smit2400/Trap_PCB/hardware/main-board/bom/TRAP_main_BOM.csv

Id | Designator | Package | Quantity | Designation | Supplier and ref
1 | R16,R23,R28 | 1206 | 3 | 100K
2 | C12,C1 | CPOL-RADIAL-2.5MM-6.5MM | 2 | 100UF 25V
3 | C2,C8,C4,C7,C11,C3,C5,C6 | 1206 | 8 | smd
4 | C10 | 1206 | 1 | NC
5 | J4,J6,J5 | JST_EH_B2B-EH-A_1x02_P2.50mm_Vertical | 3 | 01x02
6 | J1,J8,J3,J7,J10,J11,J2,J9 | 1X02 | 8 | 01x02
7 | R27 | 1206 | 1 | 11K
8 | D1,D2 | 1210 | 2 | D_Schottky
9 | Q1 | SOT23-3 | 1 | 2A PNP tran
10 | R29,R10,R5,R30,R6,R24,R11 | 1206 | 7 | 10K
11 | R4,R25,R33,R22,R26,R32,R15,R12,R2,R1,R13,R34 | 1206 | 12 | 1K
12 | D3,D4 | 1210 | 2 | D_Zener
13 | IC1 | SOP65P810X140-30N | 1 | R5F100ACASP#V0-R5F100ACASP#V0
14 | R31,R9,R39,R41 | 1206 | 4 | 0
15 | R37,R38,R20,R35,R40,R36 | 1206 | 6 | JMP
16 | R14 | 1206 | 1 | 51K
17 | Q5 | SOT23-3 | 1 | 5C2
18 | R17 | 1206 | 1 | 2E
19 | Q7 | SOT23-3 | 1 | A49T
20 | R19,R8,R3 | 1206 | 3 | 100
21 | D8,D7 | LED-1206 | 2 | LED
22 | J12 | 1X04 | 1 | 01x04
23 | C9 | CAPPRD500W60D1000H1250 | 1 | 100uF 35V
24 | Q2 | SOT23-3 | 1 | W1p
25 | Q4 | SOT23-3 | 1 | W1P
26 | U1 | SOT89R | 1 | MC78L05_TO92
27 | Q6 | SOT23-3 | 1 | W1P
28 | R18 | 1206 | 1 | 4.7K
29 | R21 | 1206 | 1 | 5.1
30 | D5 | 1210 | 1 | 1N4007
31 | R7 | 1206 | 1 | 22K
32 | D6 | 1210 | 1 | NC
33 | Q3 | SOT23-3 | 1 | A19T
34 | J13 | 1X02_BIG | 1 | 01x02
