smit2400/Trap_PCB/hardware/main-board/Trap_smit.kicad_pcb

## KiCad design hardware/main-board/Trap_smit.kicad_pcb (2026-11-07)

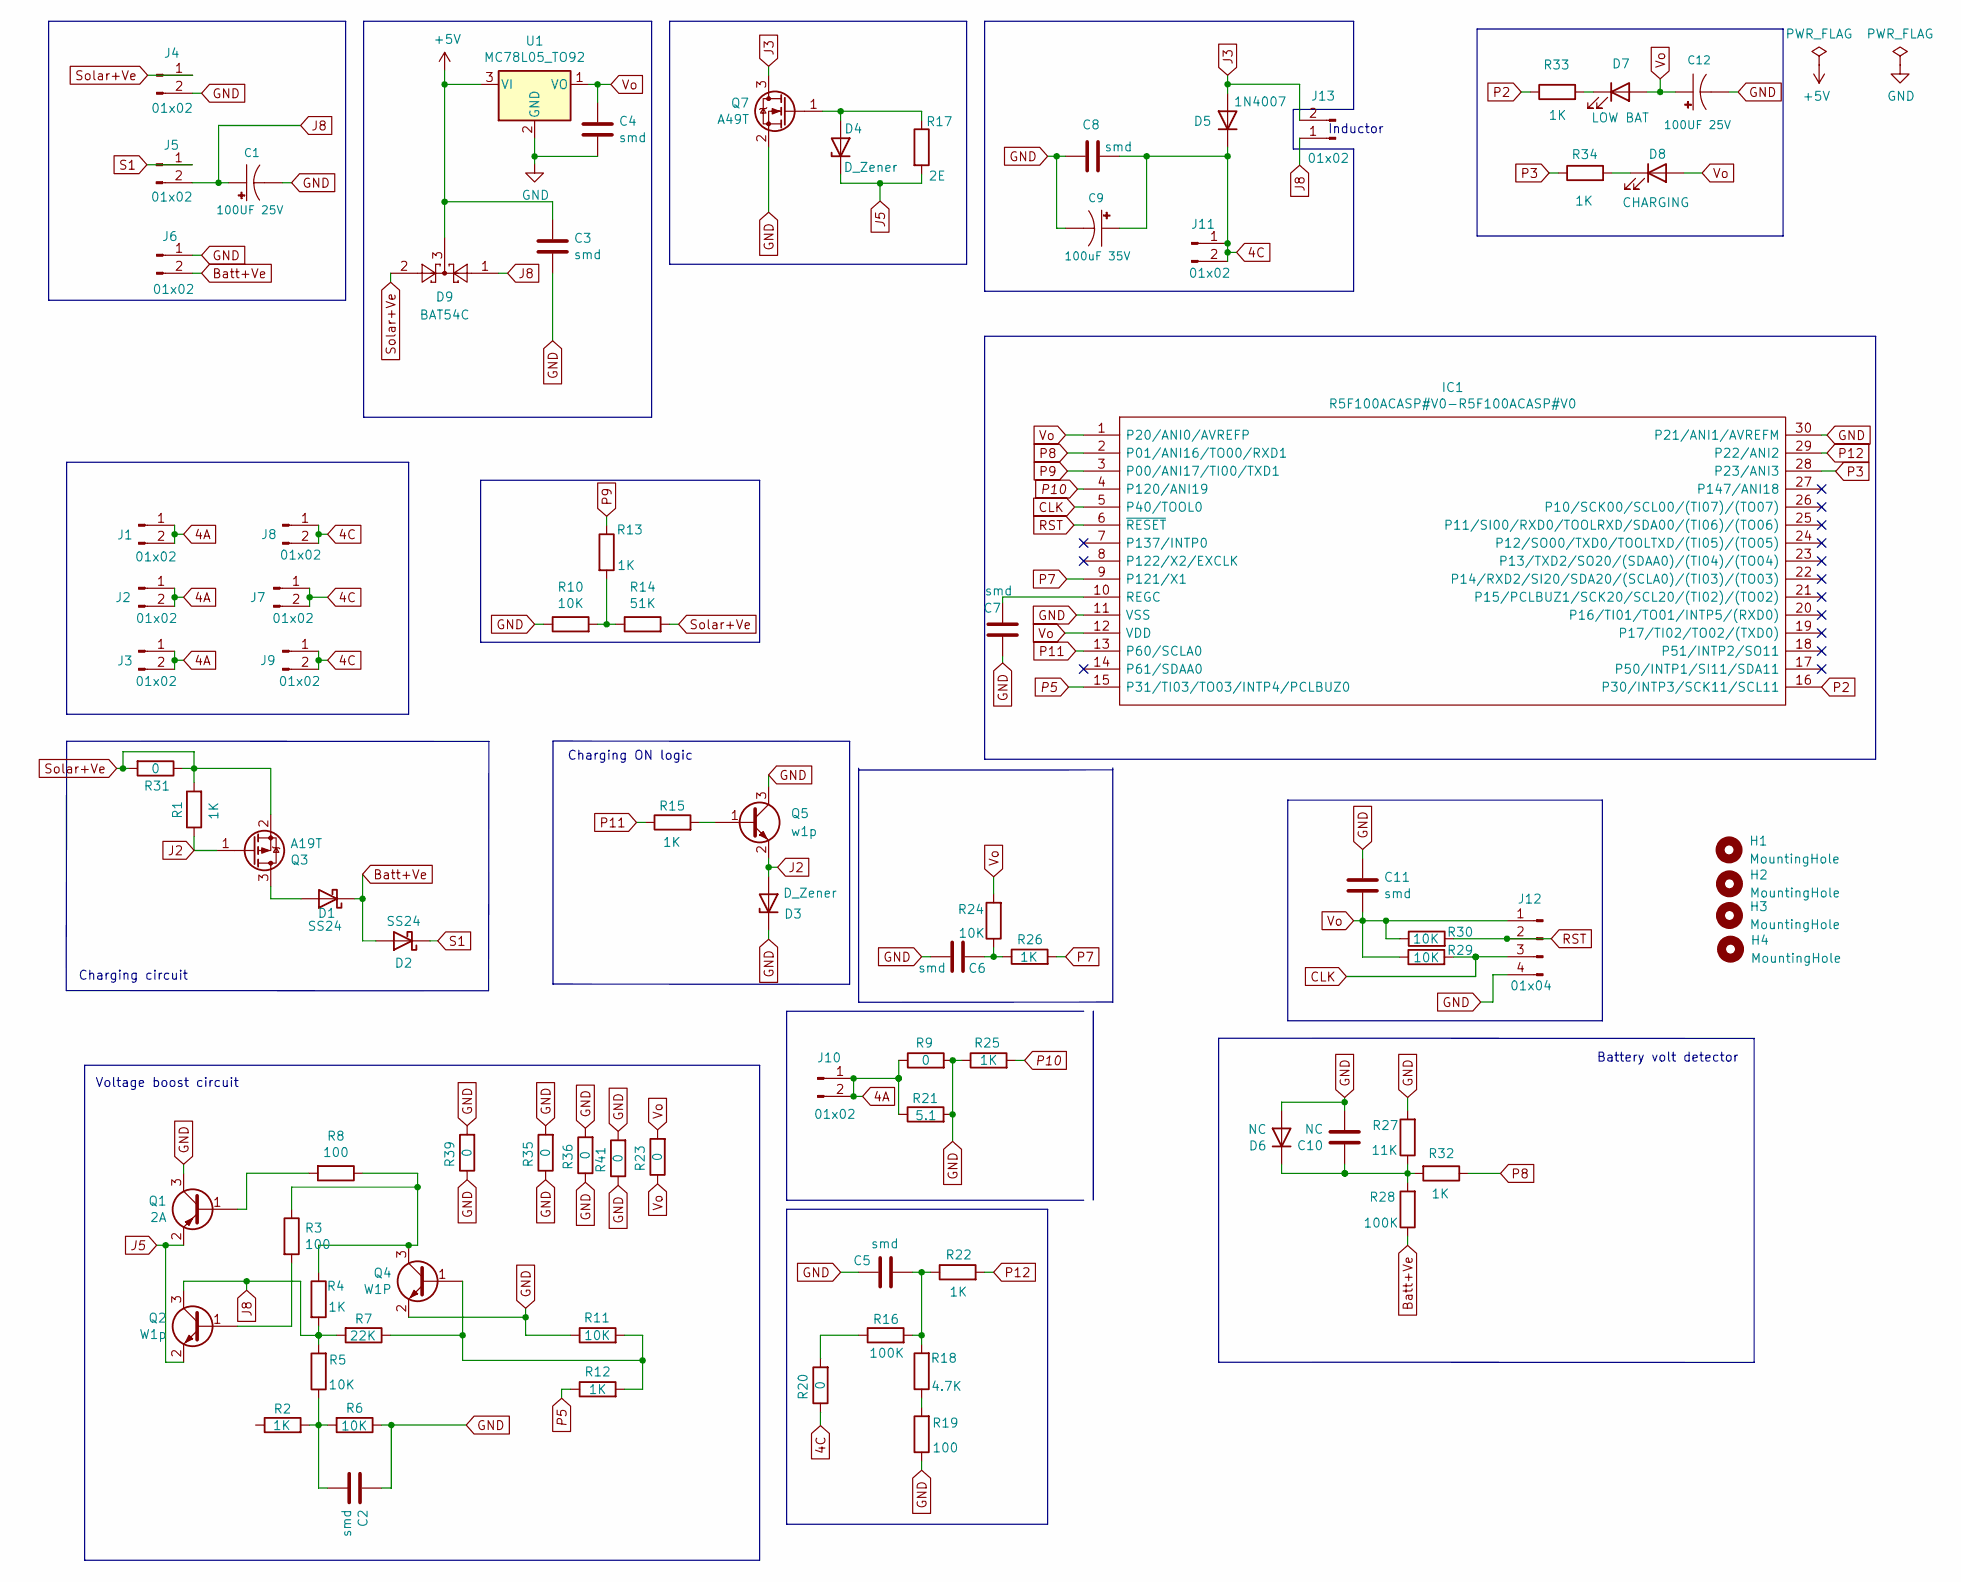
[picture p2: schematic Trap_smit.kicad_sch]

Parts:
C1, C12: 100UF 25V; CPOL-RADIAL-2.5MM-6.5MM
C2, C3, C4, C5, C6, C7, C8, C11: smd; 1206
C9: 100uF 35V; CAPPRD500W60D1000H1250
C10: NC; 1206
D1, D2: SS24; 1210
D3, D4: D_Zener; 1210
D5: 1N4007; 1210
D6: NC; 1210
D7: LOW BAT; LED-1206
D8: CHARGING; LED-1206
D9: BAT54C; SOT23-3
H1, H2, H3, H4: MountingHole; MountingHole_3.2mm_M3
IC1: R5F100ACASP#V0-R5F100ACASP#V0; SOP65P810X140-30N; Manufacturer_Part_Number R5F100ACASP#V0; Mouser Part Number 968-R5F100ACASP#V0
J1, J2, J3, J7, J8, J9, J10, J11: 01x02; 1X02
J4, J5, J6: 01x02; JST_EH_B2B-EH-A_1x02_P2.50mm_Vertical
J12: 01x04; 1X04
J13: 01x02; 1X02_BIG
Q1: 2A; SOT23-3
Q2: W1p; SOT23-3
Q3: A19T; SOT23-3
Q4: W1P; SOT23-3
Q5: w1p; SOT23-3
Q7: A49T; SOT23-3
R1, R2, R4, R12, R13, R15, R22, R25, R26, R32, R33, R34: 1K; 1206
R3, R8, R19: 100; 1206
R5, R6, R10, R11, R24, R29, R30: 10K; 1206
R7: 22K; 1206
R9, R20, R23, R31, R35, R36, R39, R41: 0; 1206
R14: 51K; 1206
R16, R28: 100K; 1206
R17: 2E; 1206
R18: 4.7K; 1206
R21: 5.1; 1206
R27: 11K; 1206
U1: MC78L05_TO92; SOT89R

Connections:
4A: J1.1, J1.2, J2.1, J2.2, J3.1, J3.2, J10.1, J10.2, R9.1, R21.1
4C: C8.2, C9.+, D5.1 (K), J7.1, J7.2, J8.1, J8.2, J9.1, J9.2, J11.1, J11.2, R20.1
+5V: C3.1, D9.3, U1.3 (VI)
Batt+Ve: D1.1 (K), D2.2 (A), J6.2, R28.1
CLK: IC1.5 (P40/TOOL0), J12.3, R29.2
GND: C1.2 (-), C2.1, C3.2, C4.2, C5.1, C6.2, C7.2, C8.1, C9.-, C10.2, C11.1, C12.2 (-), D3.1 (K), D6.2 (A), IC1.11 (VSS), IC1.30 (P21/ANI1/AVREFM), J4.2, J6.1, J12.4, Q1.3 (C), Q4.2 (E), Q5.3 (C), Q7.2 (S), R6.1, R9.2, R10.1, R11.1, R19.1, R21.2, R25.1, R27.2, R35.1, R35.2, R36.1, R36.2, R39.1, R39.2, R41.1, R41.2, U1.2 (GND)
J2: D3.2 (A), Q3.1 (G), Q5.2 (E), R1.1
J3: D5.2 (A), J13.2, Q7.3 (D)
J5: D4.1 (K), Q1.2 (E), Q2.2 (E), R17.2
J8: C1.1 (+), D9.1, J5.2, J13.1, Q2.3 (C), R4.2, R5.2, R7.2
unnamed: C2.2, R2.2, R5.1, R6.2
unnamed: C5.2, R16.2, R18.2, R22.1
unnamed: C6.1, R24.1, R26.1
unnamed: C7.1, IC1.10 (REGC)
unnamed: C10.1, D6.1 (K)
unnamed: D1.2 (A), Q3.3 (D)
unnamed: D4.2 (A), Q7.1 (G), R17.1
unnamed: D7.1 (K), R33.2
unnamed: D8.1 (K), R34.2
unnamed: Q1.1 (B), R8.2
unnamed: Q2.1 (B), R3.2
unnamed: Q4.1 (B), R7.1, R11.2, R12.2
unnamed: Q4.3 (C), R3.1, R4.1, R8.1
unnamed: R10.2, R13.2, R14.1
unnamed: Q5.1 (B), R15.2
unnamed: R16.1, R20.2
unnamed: R18.1, R19.2
unnamed: R27.1, R28.2, R32.2
P2: IC1.16 (P30/INTP3/SCK11/SCL11), R33.1
P3: IC1.28 (P23/ANI3), R34.1
P5: IC1.15 (P31/TI03/TO03/INTP4/PCLBUZ0), R12.1
P7: IC1.9 (P121/X1), R26.2
P8: IC1.2 (P01/ANI16/TO00/RXD1), R32.1
P9: IC1.3 (P00/ANI17/TI00/TXD1), R13.1
P10: IC1.4 (P120/ANI19), R25.2
P11: IC1.13 (P60/SCLA0), R15.1
P12: IC1.29 (P22/ANI2), R22.2
RST: IC1.6 (~RESET), J12.2, R30.2
S1: D2.1 (K), J5.1
Solar+Ve: D9.2, J4.1, Q3.2 (S), R1.2, R14.2, R31.1, R31.2
Vo: C4.1, C11.2, C12.1 (+), D7.2 (A), D8.2 (A), IC1.1 (P20/ANI0/AVREFP), IC1.12 (VDD), J12.1, R23.1, R23.2, R24.2, R29.1, R30.1, U1.1 (VO)

Notes on the sheet:
Charging ON logic
Inductor
Battery volt detector
Charging circuit
Voltage boost circuit

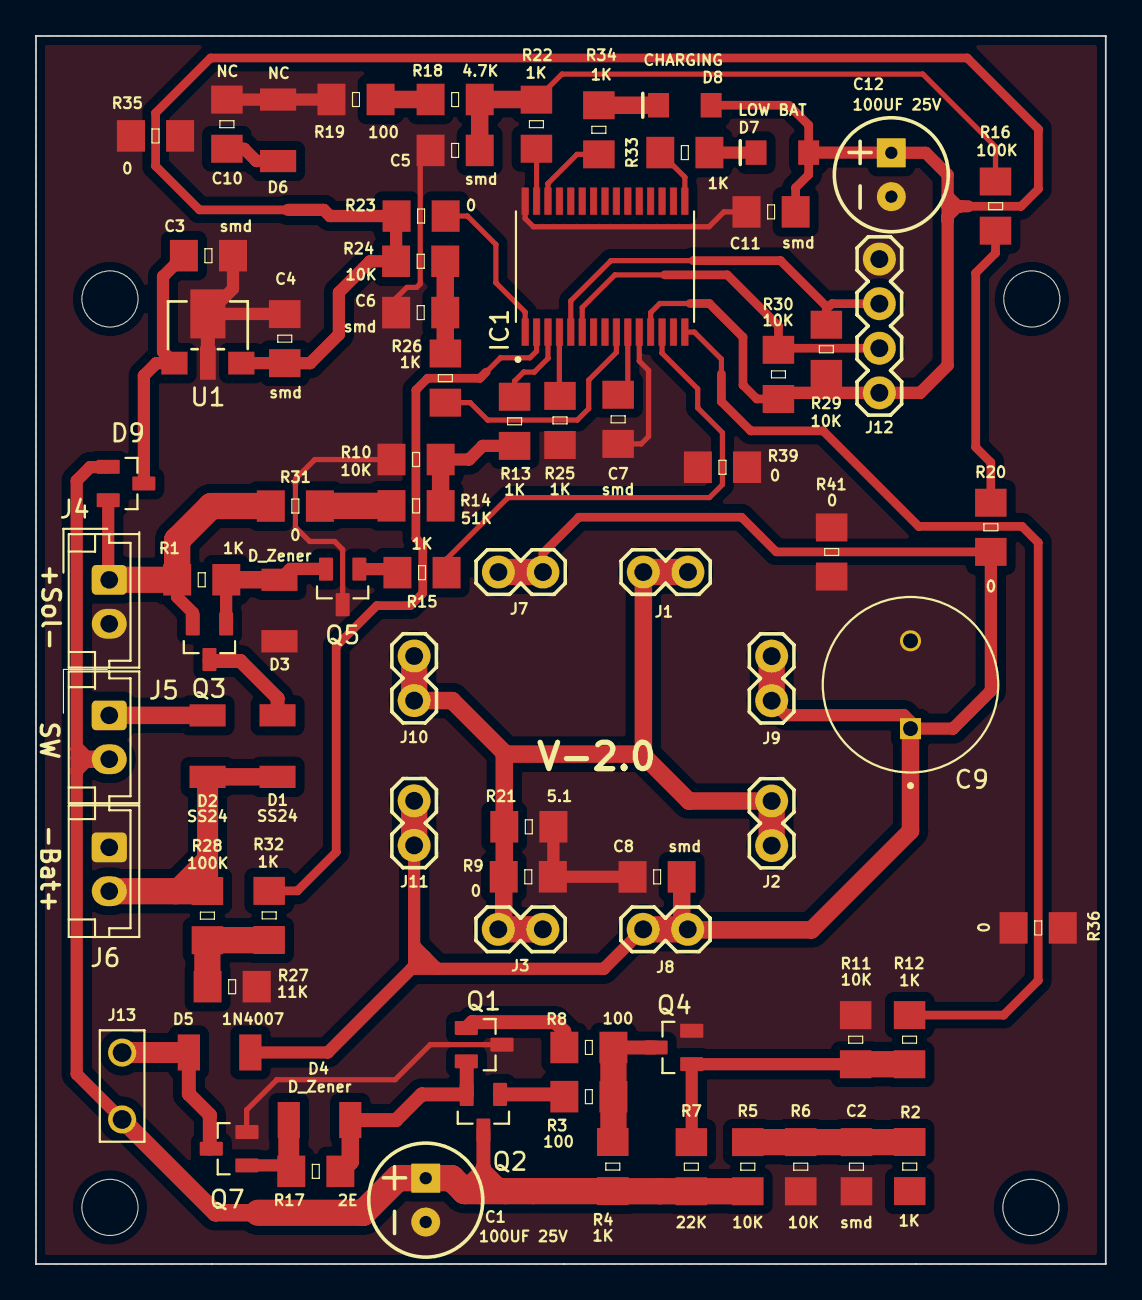
[picture p3: board Trap_smit.kicad_pcb from above]

Board: 2 copper layers, 61.0 x 70.0 mm, 84 parts (0 on the bottom side), 41 nets.
