smit2400/Trap_PCB/hardware/led-board/TRAP_LED.kicad_pcb

## KiCad design hardware/led-board/TRAP_LED.kicad_pcb (2026-11-07)

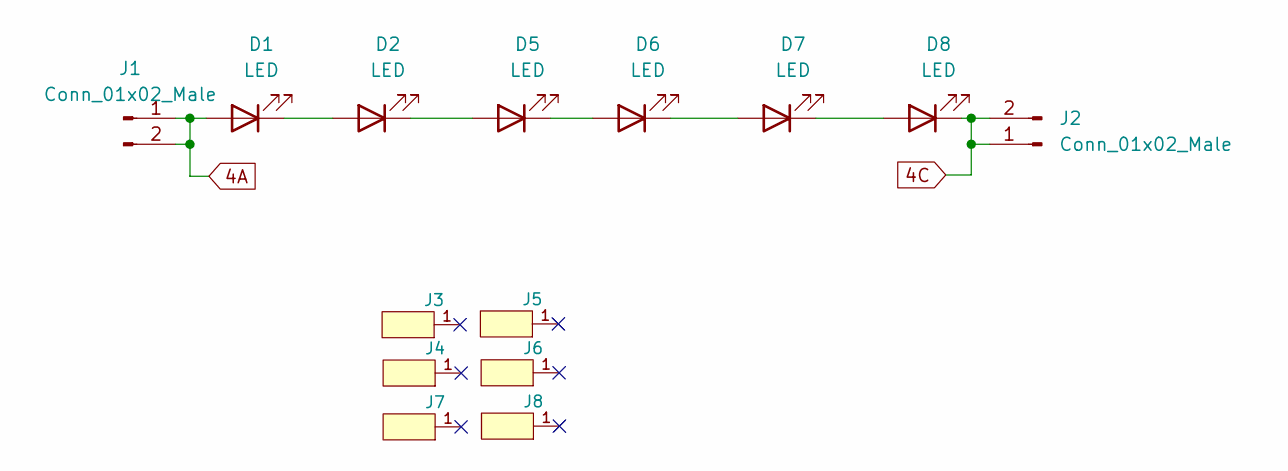
[picture p4: schematic TRAP_LED.kicad_sch]

Parts:
D1, D2, D5, D6, D7, D8: LED; LED_PLCC-2
J1, J2: Conn_01x02_Male; 1X02
J3, J5, J7, J8: CONN_01; Test_pad
J4, J6: CONN_01; TestPad_Trap_LED

Connections:
4A: D1.2 (A), J1.1, J1.2
4C: D8.1 (K), J2.1, J2.2
unnamed: D1.1 (K), D2.2 (A)
unnamed: D2.1 (K), D5.2 (A)
unnamed: D5.1 (K), D6.2 (A)
unnamed: D6.1 (K), D7.2 (A)
unnamed: D7.1 (K), D8.2 (A)

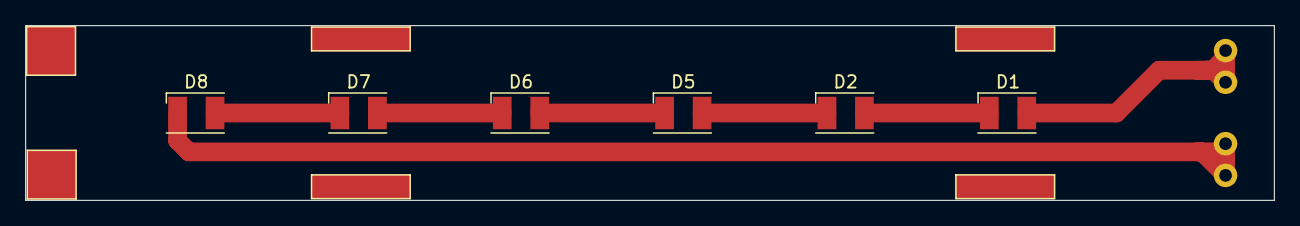
[picture p5: board TRAP_LED.kicad_pcb from above]

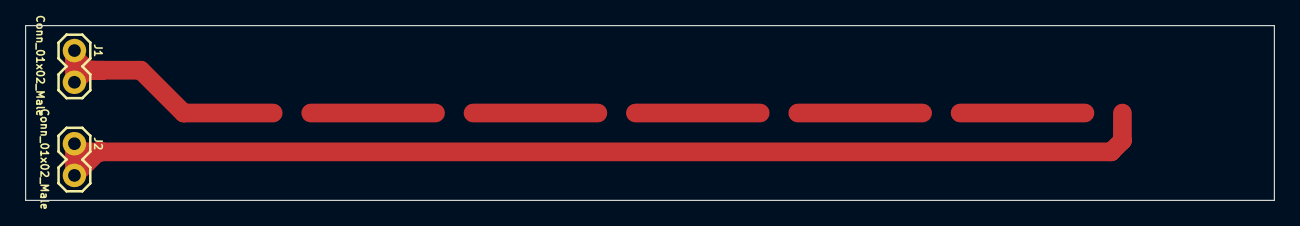
[picture p6: board TRAP_LED.kicad_pcb from below]

Board: 2 copper layers, 100.0 x 14.0 mm, 14 parts (2 on the bottom side), 7 nets.
